bjin2364/honors-thesis/README.md

# End Effector for Grasping and Locomotion #

End-effector design for the ubot-7 robot. Contains: 

- CAD model for the end effector: assembly is GL_Hand.asm 
- FEA models for design optimization and hyperelastic material design. Must be viewed using ANSYS
- Thesis manuscript
- Poster presentation
