bjin2364/honors-thesis/Solidworks_Models/GL_Hand/Part2.sldprt

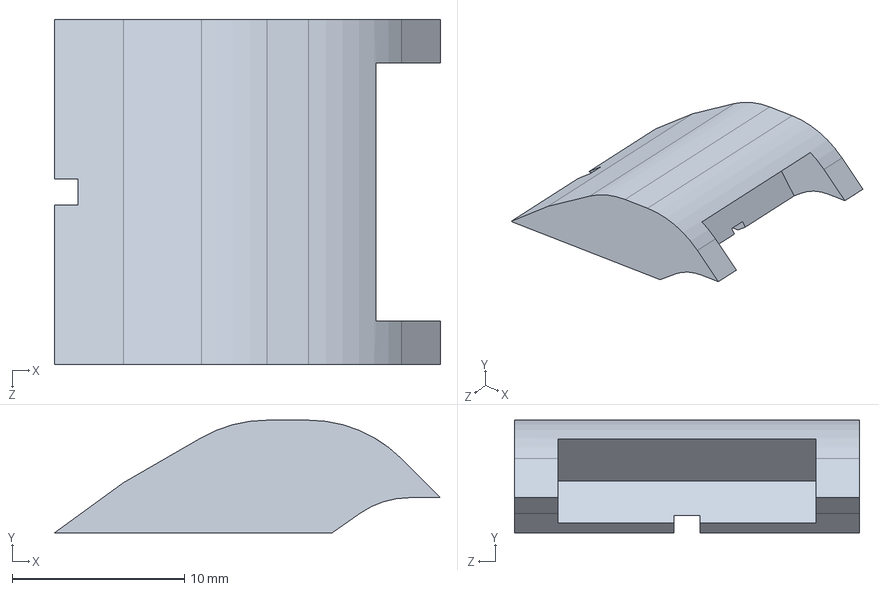
[picture p66: CAD file, 2019-02-20]
Solidworks_Models/GL_Hand/Part2.sldprt
22.4 x 6.54 x 20.0 mm
