bjin2364/honors-thesis/(list of files, cad)

Other CAD files:
Solidworks_Models/GL_Hand/quarter inch to 4mm.SLDASM
Solidworks_Models/GL_Hand/GL_Hand.SLDASM
Solidworks_Models/GL_Hand/motor housing assembly.SLDASM
Solidworks_Models/GL_Hand/tendon_driver2.SLDASM
Solidworks_Models/GL_Hand/tendon driver.SLDASM
Solidworks_Models/GL_Hand/encoder.SLDPRT
Solidworks_Models/GL_Hand/10M15_dowelpin.SLDPRT
Solidworks_Models/GL_Hand/side_plate1.SLDPRT
Solidworks_Models/GL_Hand/ulnar_deviation_compliantMaterial.SLDPRT
Solidworks_Models/GL_Hand/pulley2.SLDPRT
Solidworks_Models/GL_Hand/compliant_filling_2.0.SLDPRT
Solidworks_Models/GL_Hand/EC20max_5W.SLDPRT
Solidworks_Models/GL_Hand/side_plate_5.SLDPRT
Solidworks_Models/GL_Hand/output_link2.SLDPRT
Solidworks_Models/GL_Hand/waterbottle.SLDPRT
Solidworks_Models/GL_Hand/side_plate2.SLDPRT
Solidworks_Models/GL_Hand/cover.SLDPRT
Solidworks_Models/GL_Hand/spool3.SLDPRT
Solidworks_Models/GL_Hand/rigid_finger_7.1.SLDPRT
Solidworks_Models/GL_Hand/8M20_dowelpin.SLDPRT
Solidworks_Models/GL_Hand/housingA.SLDPRT
Solidworks_Models/GL_Hand/Bucket-pail.SLDPRT
Solidworks_Models/GL_Hand/tennis_ball.SLDPRT
Solidworks_Models/GL_Hand/housingB.SLDPRT
Solidworks_Models/GL_Hand/notebook.SLDPRT
Solidworks_Models/GL_Hand/capstan2.SLDPRT
Solidworks_Models/GL_Hand/holder.SLDPRT
Solidworks_Models/GL_Hand/motor_platform2.SLDPRT
Solidworks_Models/GL_Hand/cylinder.SLDPRT
Solidworks_Models/GL_Hand/6M30_dowelpin.SLDPRT
Solidworks_Models/GL_Hand/credit card.SLDPRT
Solidworks_Models/GL_Hand/coin.SLDPRT
Solidworks_Models/GL_Hand/spool1.SLDPRT
Solidworks_Models/GL_Hand/fingerBase_5.0.SLDPRT
Solidworks_Models/GL_Hand/Futaba Servomotor.SLDPRT
Solidworks_Models/GL_Hand/dp_finger_1.0.SLDPRT
Solidworks_Models/GL_Hand/cylinder(large).SLDPRT
Solidworks_Models/GL_Hand/Pittman Motor.SLDPRT
Solidworks_Models/GL_Hand/spacer.SLDPRT
Solidworks_Models/GL_Hand/shaft bracket.SLDPRT
Solidworks_Models/GL_Hand/6M20_dowelpin.SLDPRT
Solidworks_Models/GL_Hand/encoder_bracket1.SLDPRT
Solidworks_Models/GL_Hand/plug.SLDPRT
Solidworks_Models/GL_Hand/capstan.SLDPRT
Solidworks_Models/GL_Hand/mp_finger_2.0.SLDPRT
Solidworks_Models/GL_Hand/pp_finger_2.0.SLDPRT
Solidworks_Models/GL_Hand/penny.SLDPRT
Solidworks_Models/GL_Hand/holder2.SLDPRT
Solidworks_Models/GL_Hand/spring_fixture.SLDPRT
Solidworks_Models/GL_Hand/hand base_10.SLDPRT
Solidworks_Models/GL_Hand/sphere.SLDPRT
Solidworks_Models/GL_Hand/clamp.SLDPRT
Solidworks_Models/GL_Hand/SEA_tensioner.SLDPRT
Solidworks_Models/GL_Hand/fastener.SLDPRT
Solidworks_Models/GL_Hand/1429N2 pulley.SLDPRT
Solidworks_Models/GL_Hand/1428N27.SLDPRT
Solidworks_Models/GL_Hand/6392K410.SLDPRT
Solidworks_Models/GL_Hand/6679K310.SLDPRT
Solidworks_Models/GL_Hand/7804K111.SLDPRT
Solidworks_Models/GL_Hand/80713_1.SLDPRT
Solidworks_Models/GL_Hand/91253A106.SLDPRT
Solidworks_Models/GL_Hand/9845T102.SLDPRT
Solidworks_Models/GL_Hand/9845T104.SLDPRT
Solidworks_Models/GL_Hand/9845T110.SLDPRT
